jasser-bougatef/venom-combat-robot/docs/choix_materiel.pdf

# Choix matériels

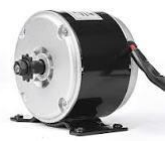
[picture p23: figure]

# Moteur : MY1016

## - Caractéristiques

Consommation de courant

À vide ➔ courant de 1-2A

En charge normale ➔ autour de 15A

En démarrage brutal ou blocage ➔ 30-40A en pointe

# Driver moteur :

Driver | Prix | Ses avantages
Cytron MDDS60 | 670d « ali express » | 60A
Flipsky FSESC 4.20 | 557 d « ubuy » | 50A + refrodissement
Sabertooth 2x32 | 120,00 € « go tronic » | 32A
Bts7960B | 21d « 2b » | 15 à 20A
- Essaie de rendre mon bts7960 B comme les autres driver
- Monte ton BTS7960 sur une plaque aluminium (radiateur bricolé).
- Prends une plaque métallique fine.
- Visse ou colle ton BTS7960 dessus pour aider à refroidir.
- Ajoute un ventilateur 5V ou 12V directement pointé sur le module.
- Un petit ventilateur PC (4x4 cm) suffit.
- L’alimentation du ventilateur peut venir de ta batterie via un petit régulateur.
- Utilise de GROS câbles entre la batterie, le BTS7960 et le moteur.
- Type 10 AWG ou 12 AWG si possible.
- Soude un condensateur directement sur l’alim du BTS7960.
- Exemple : 1000µF 35V entre VCC et GND pour lisser les pics de tension.
- Mets un fusible rapide sur le câble positif venant de ta batterie.

Code coleur :

Rouge : obligatoire

Vert : recommandé

Jaune : optionnel

- Valeur : 25A ou 30A (ça protège ton BTS7960).
- Évite de tirer 100% de la puissance moteur tout le temps.
- Si possible, limite l'accélération via ton code Arduino (PWM progressif).

# Alimentation :

Une batterie Li-Po 6S (qui signifie 6 cellules en série) est idéale, car elle fournit une tension de 22.2V nominale (3.7V x 6) et jusqu'à 25.2V à pleine charge, ce qui est parfaitement adapté pour un moteur 24V.

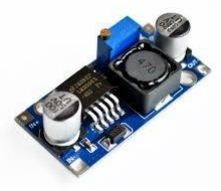
[picture p24: figure]

Carte commande : esp32 + un convertisseur buck

(LM2596 5.4 D ) convertir 24 v en 5 v pour alimente le carte esp 32 )

# Manette
