jasser-bougatef/venom-combat-robot/analysis/shaft_bending/1f.png

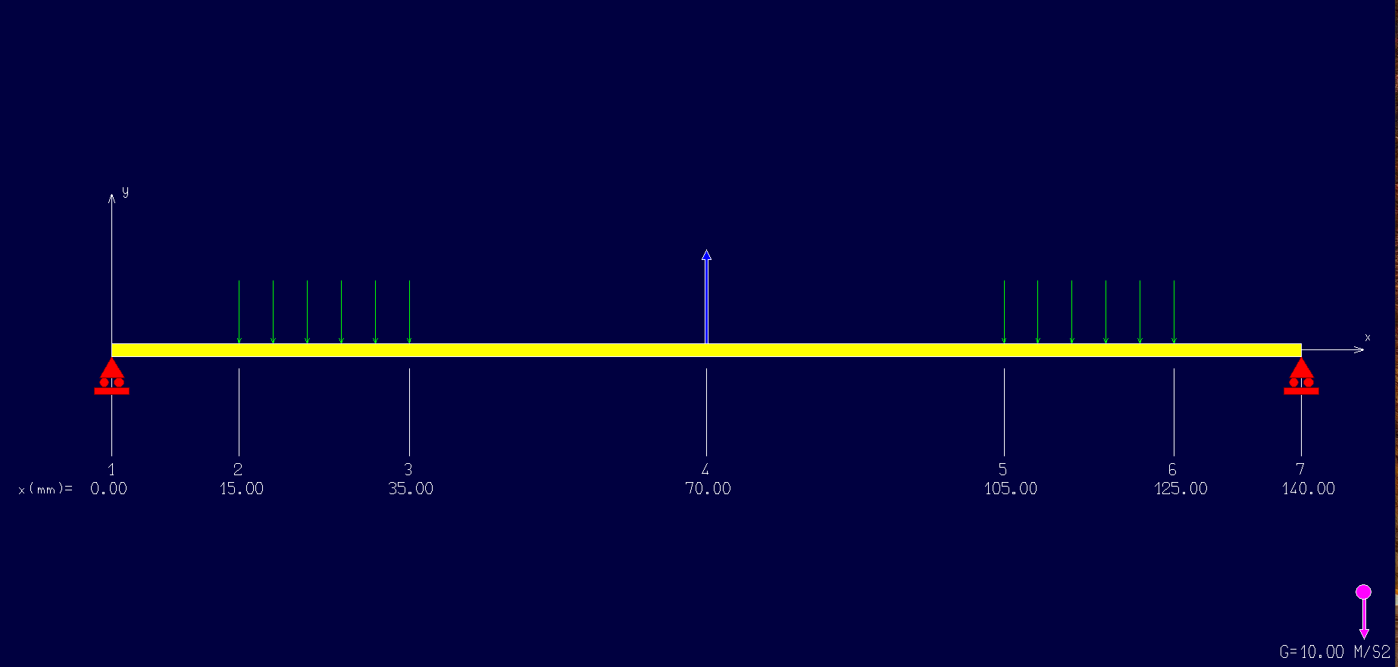
analysis/shaft_bending/1f.png
