jasser-bougatef/venom-combat-robot/analysis/shaft_bending/capture.png

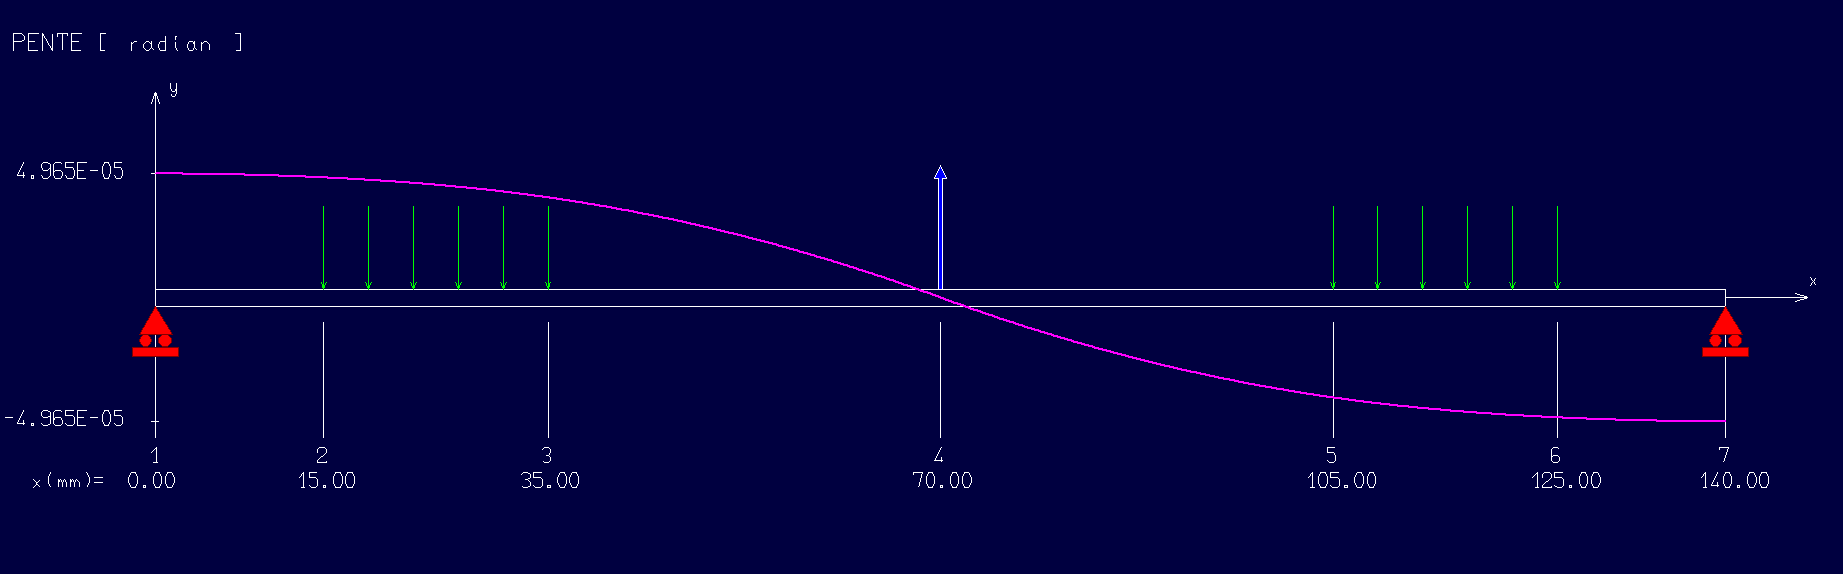
analysis/shaft_bending/capture.png
