jasser-bougatef/venom-combat-robot/analysis/shaft_bending/f2.png

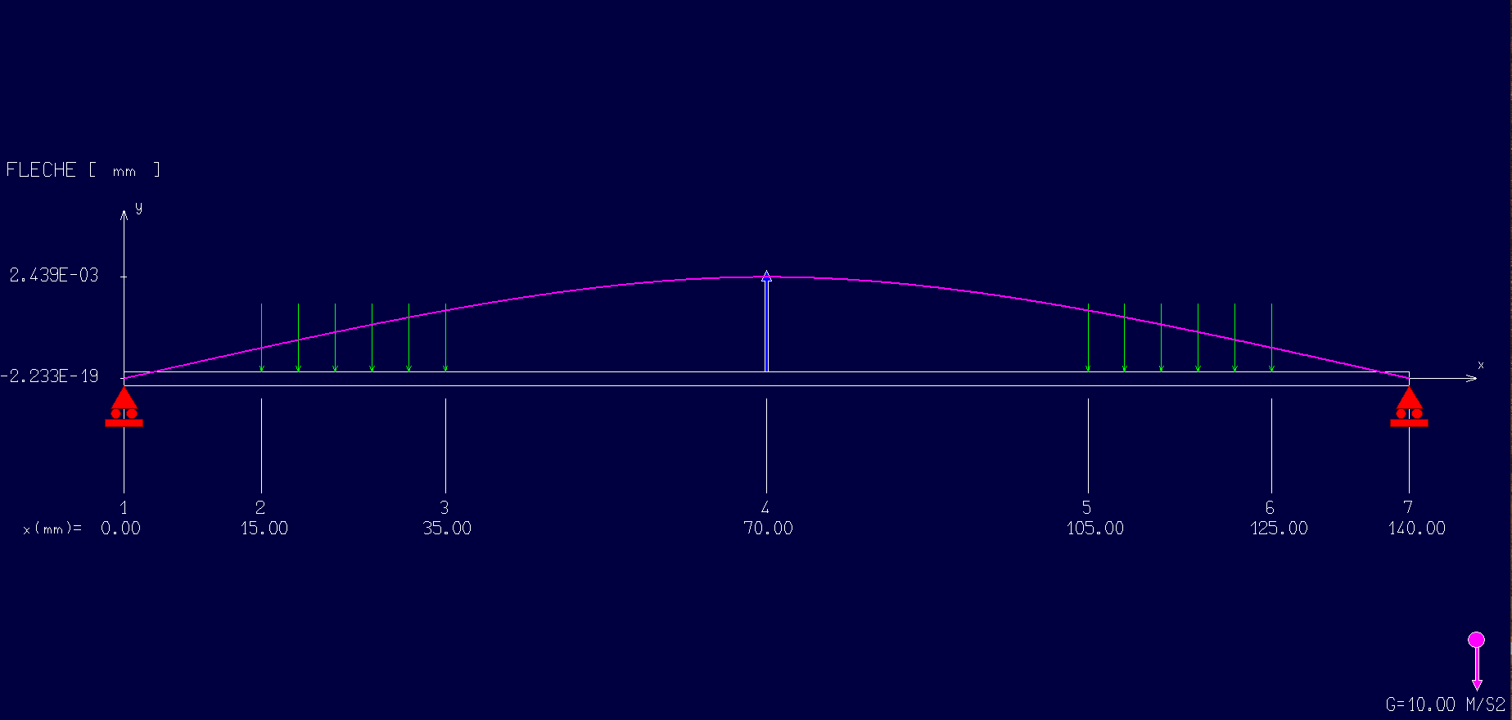
analysis/shaft_bending/f2.png
