jasser-bougatef/venom-combat-robot/analysis/shaft_bending/f3.png

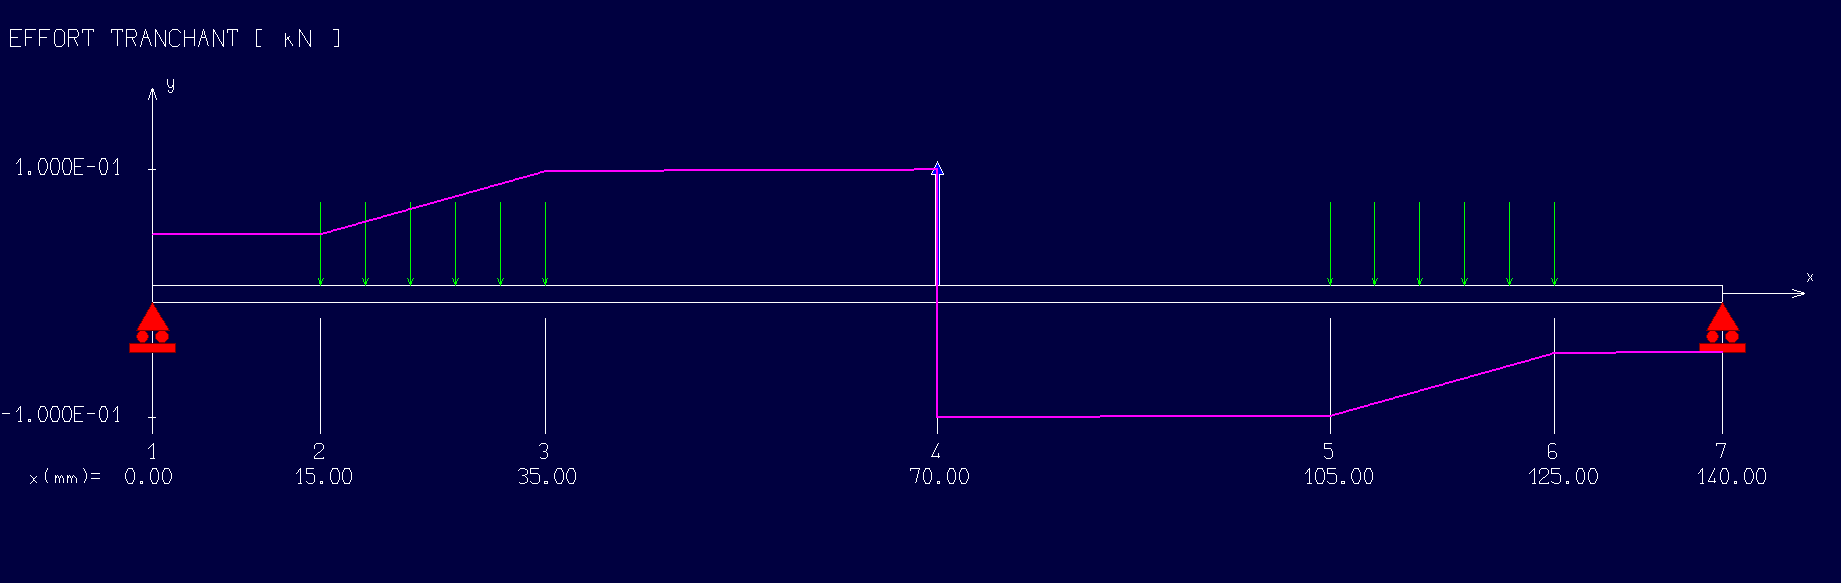
analysis/shaft_bending/f3.png
