jasser-bougatef/venom-combat-robot/analysis/shaft_bending/f4.png

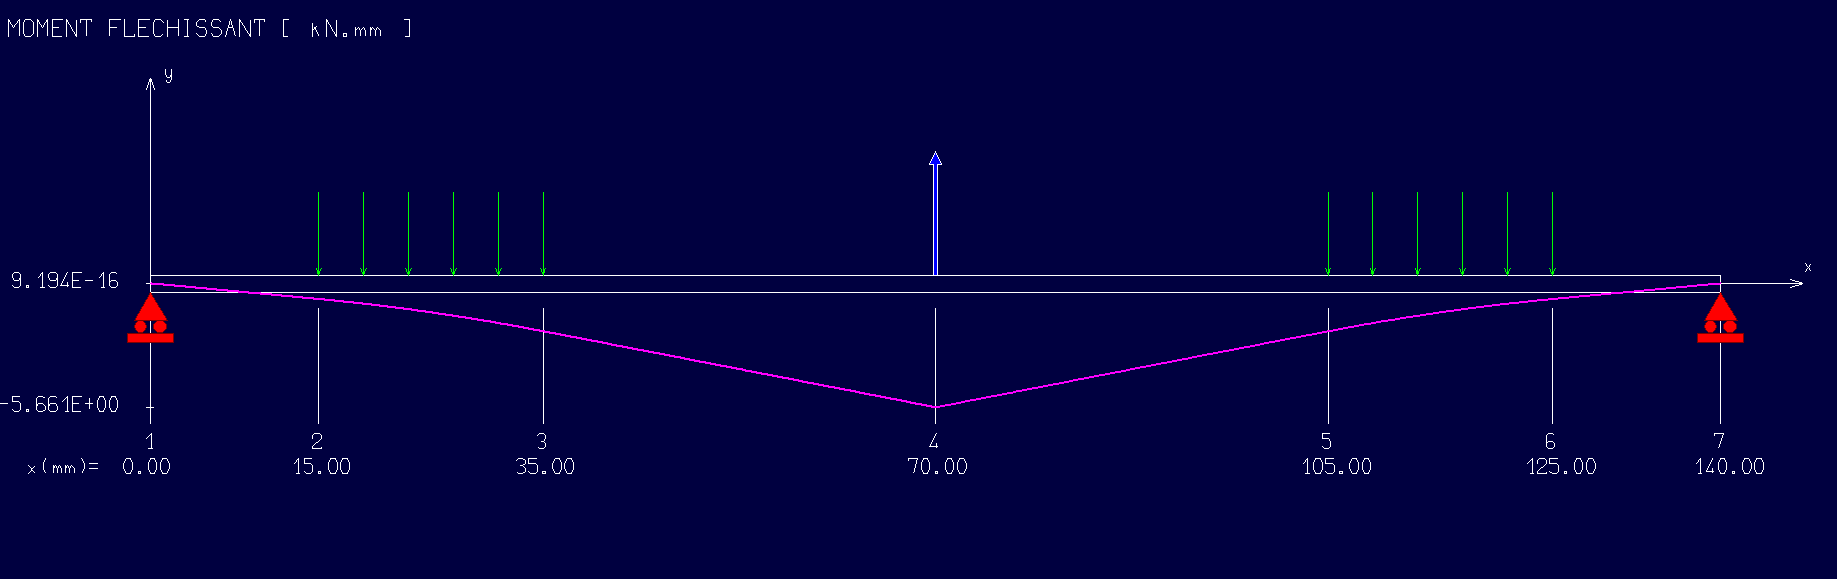
analysis/shaft_bending/f4.png
