jasser-bougatef/venom-combat-robot/analysis/shaft_bending/f5.png

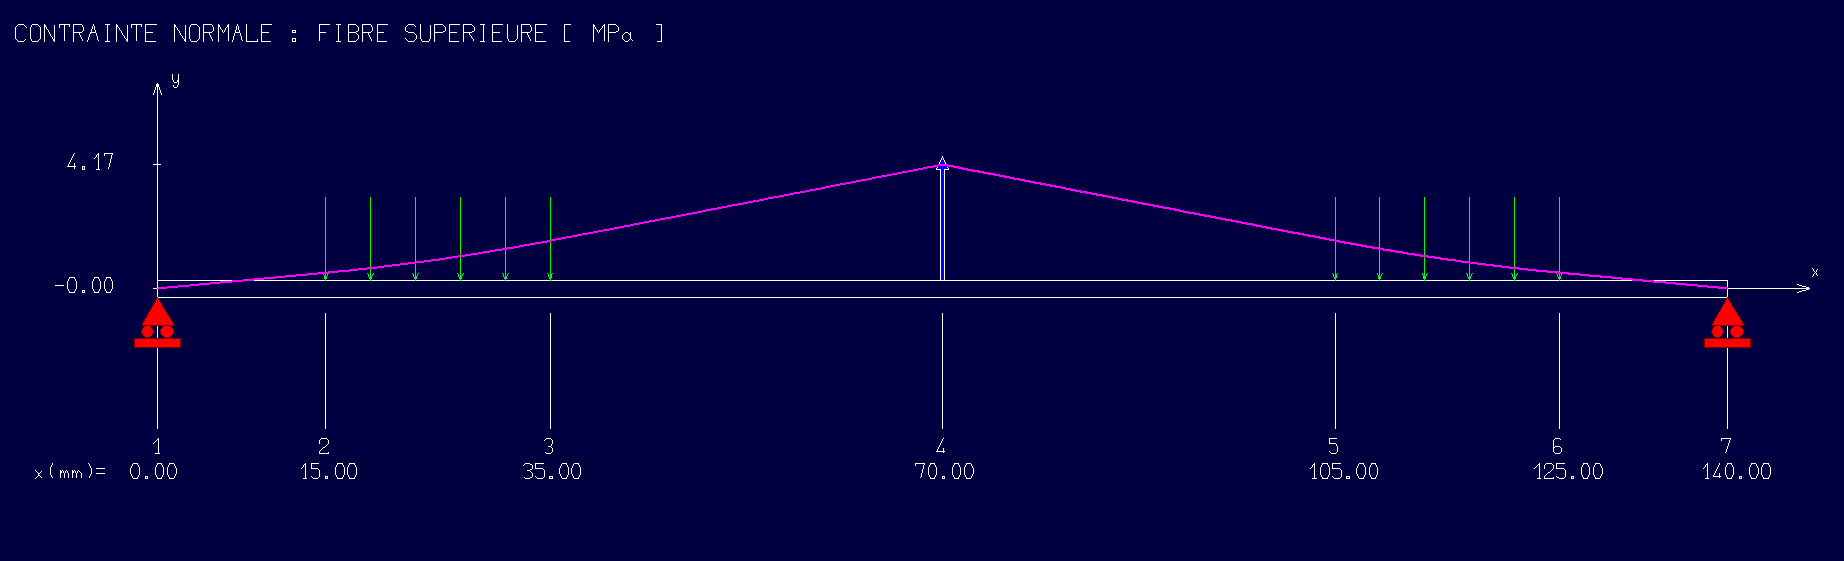
analysis/shaft_bending/f5.png
