jasser-bougatef/venom-combat-robot/analysis/shaft_bending/f6.png

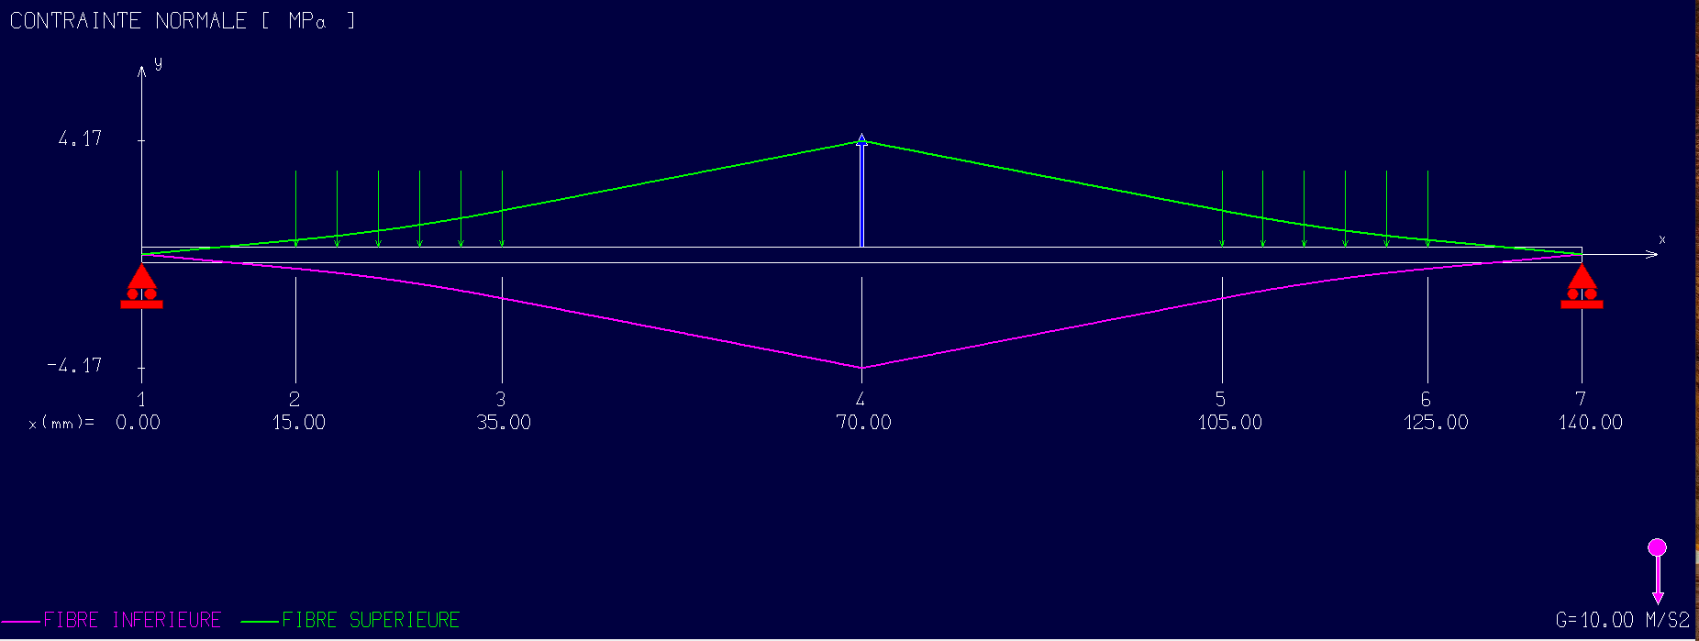
analysis/shaft_bending/f6.png
