jasser-bougatef/venom-combat-robot/analysis/shaft_bending/f7.png

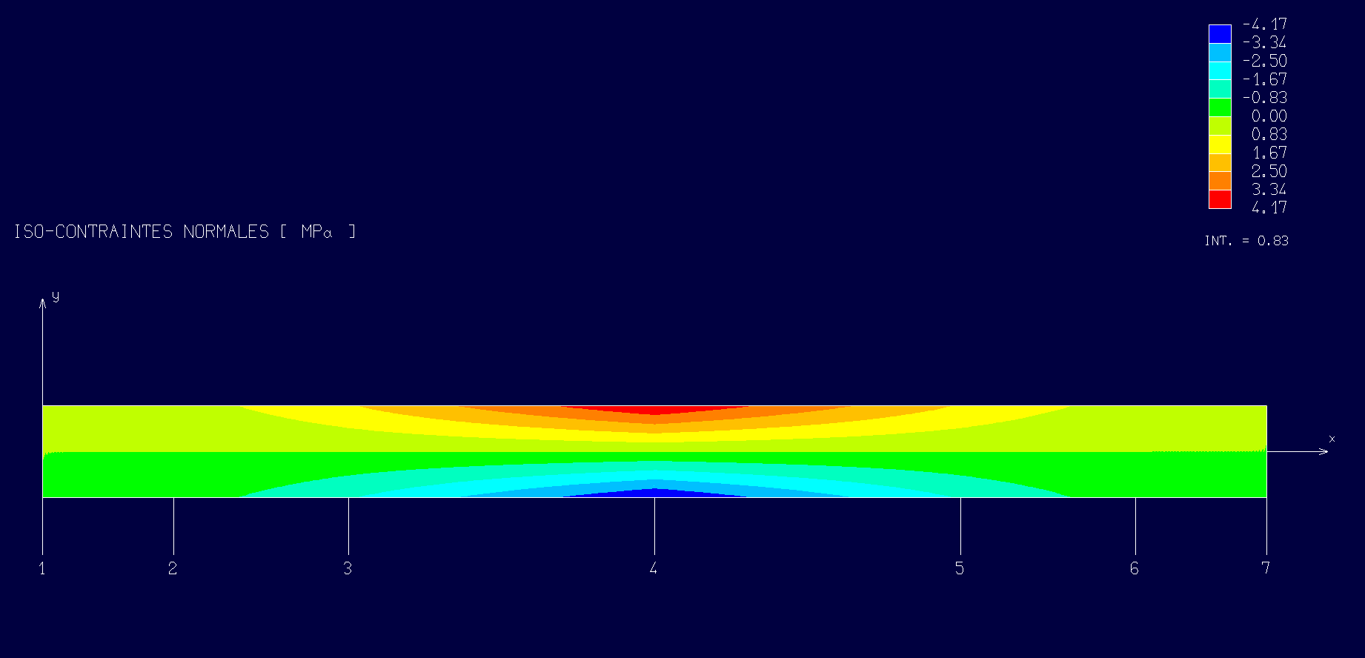
analysis/shaft_bending/f7.png
