jasser-bougatef/venom-combat-robot/cad/images/vue_1.png

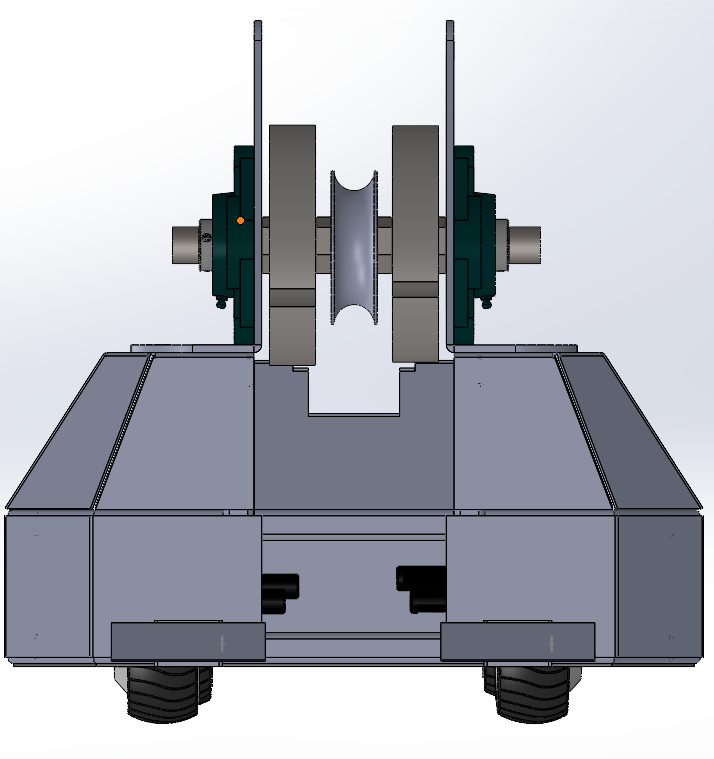
cad/images/vue_1.png
