jasser-bougatef/venom-combat-robot/cad/images/vue_2.png

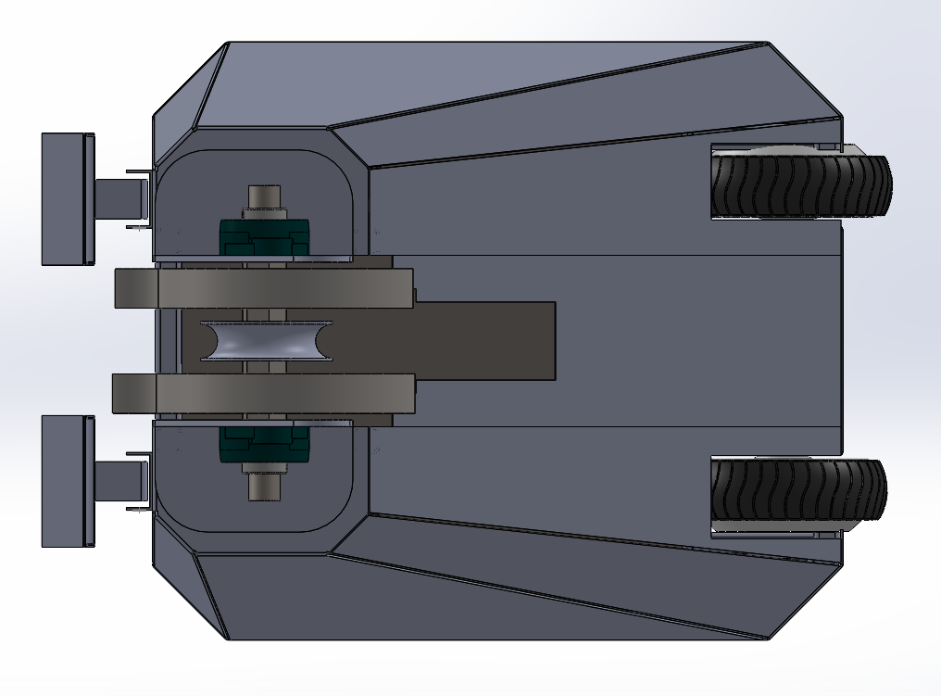
cad/images/vue_2.png
