jasser-bougatef/venom-combat-robot/cad/images/vue_3.png

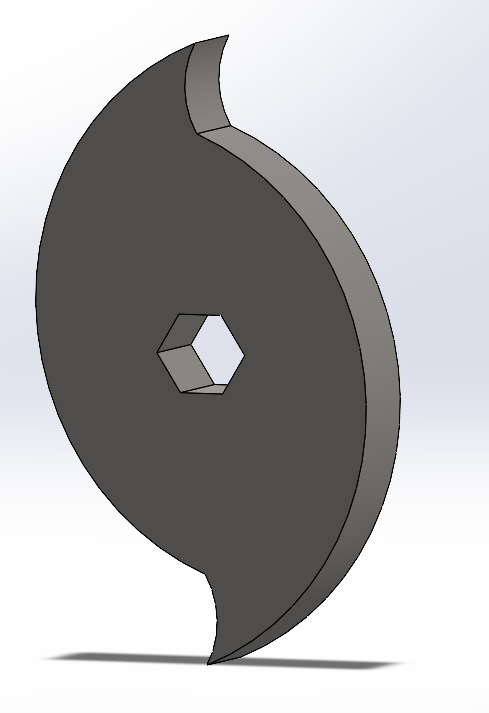
cad/images/vue_3.png
