jasser-bougatef/venom-combat-robot/cad/images/vue_4.png

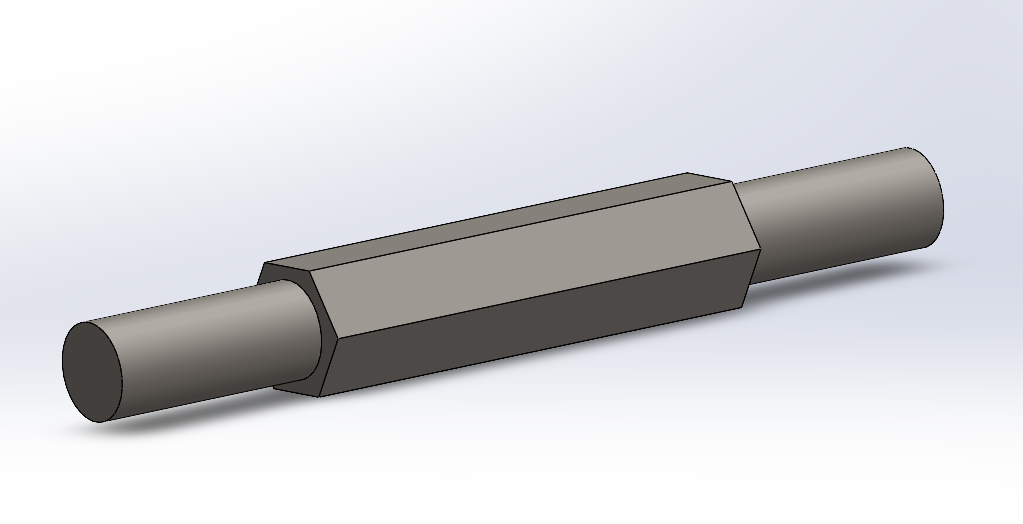
cad/images/vue_4.png
