jasser-bougatef/venom-combat-robot/electrical/images/commande_arme.png

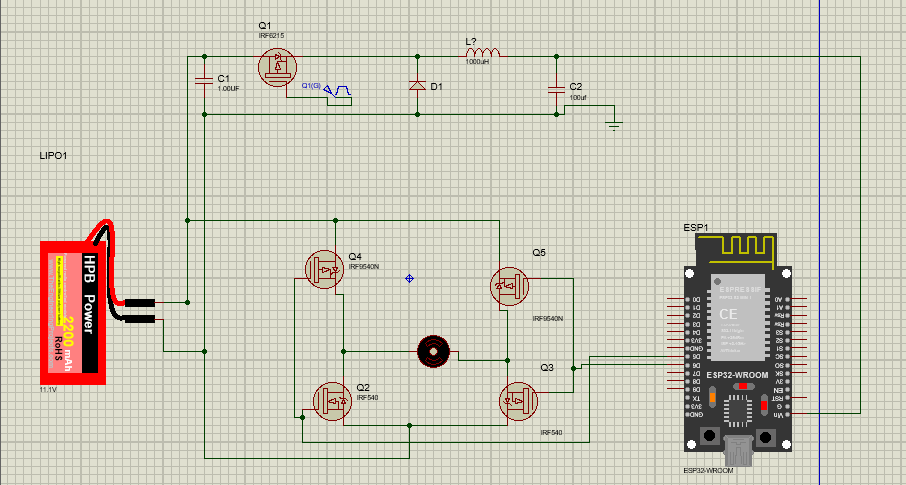
electrical/images/commande_arme.png
