jasser-bougatef/venom-combat-robot/electrical/images/commande_moteurs.png

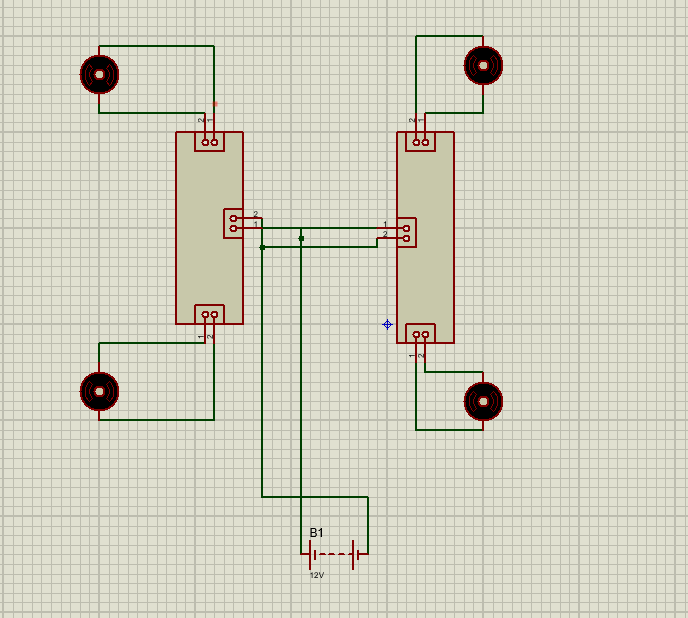
electrical/images/commande_moteurs.png
