jasser-bougatef/venom-combat-robot/firmware/hoverboard_stm32/carte_hoverboard.jpg

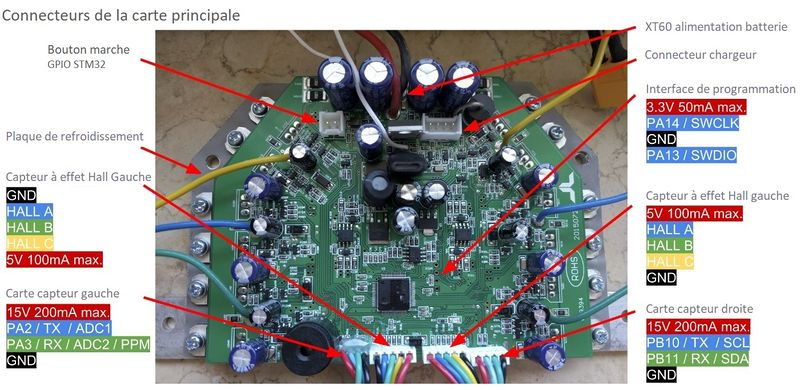
firmware/hoverboard_stm32/carte_hoverboard.jpg
