jasser-bougatef/venom-combat-robot/firmware/hoverboard_stm32/st_link_flash.jpg

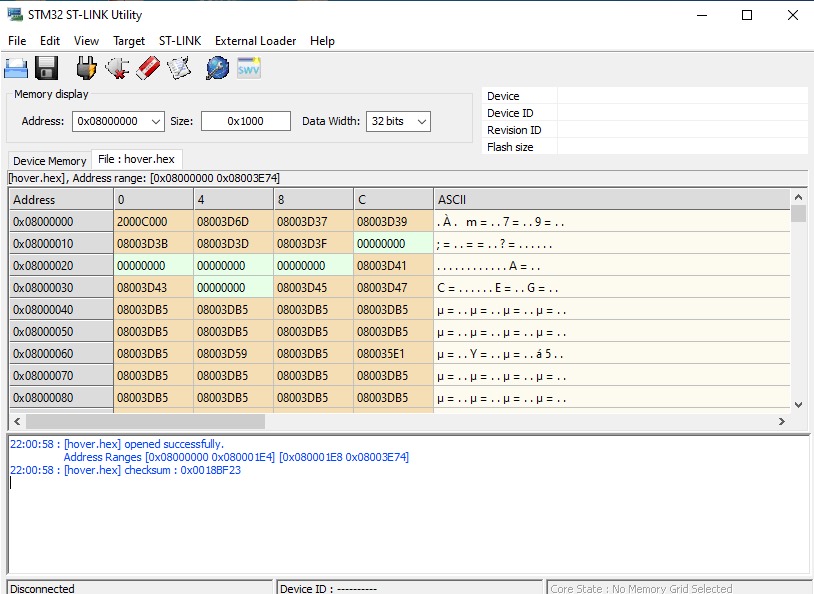
firmware/hoverboard_stm32/st_link_flash.jpg
