jasser-bougatef/venom-combat-robot/media/venom-abaqus.jpg

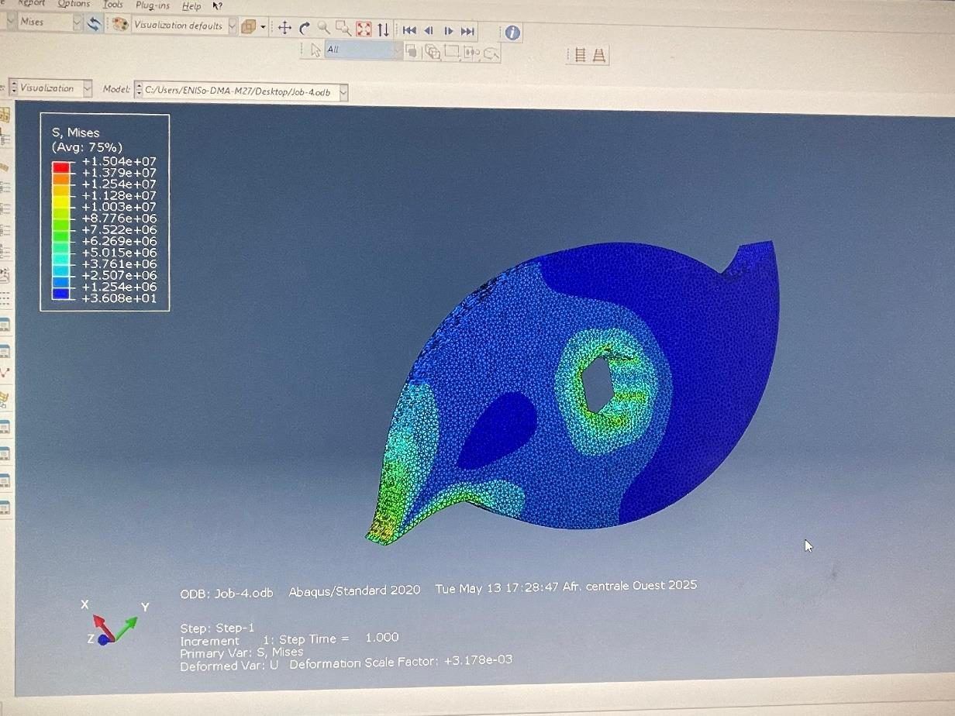
media/venom-abaqus.jpg
