jasser-bougatef/venom-combat-robot/media/venom-team.jpg

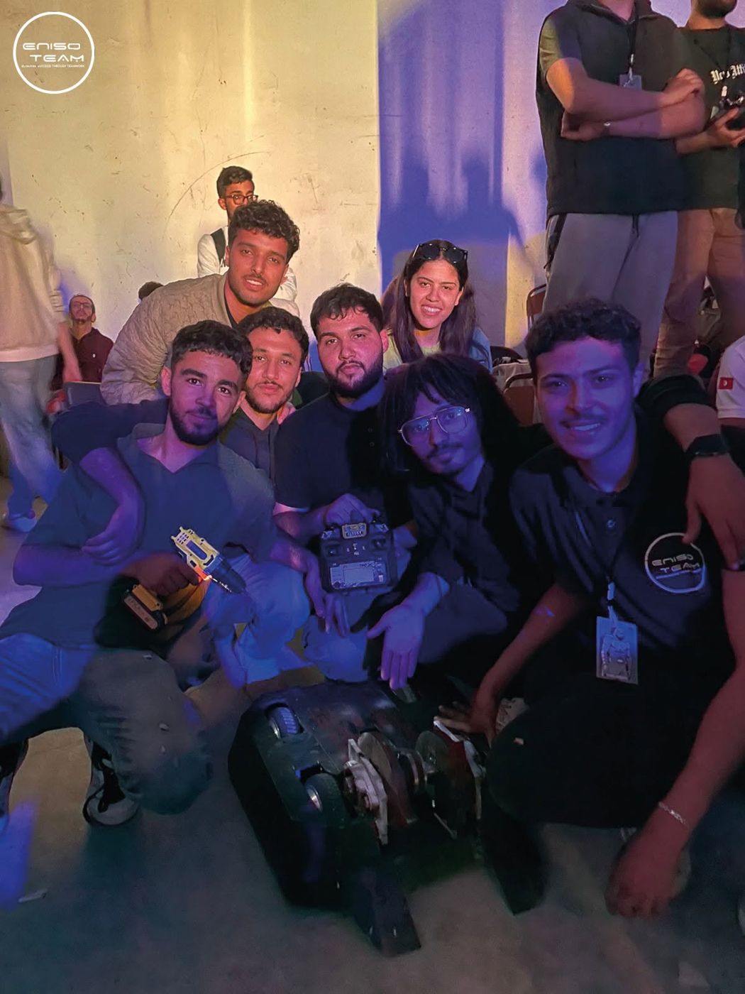
media/venom-team.jpg
