jasser-bougatef/venom-combat-robot/cad/solidworks/fighter bot.SLDASM

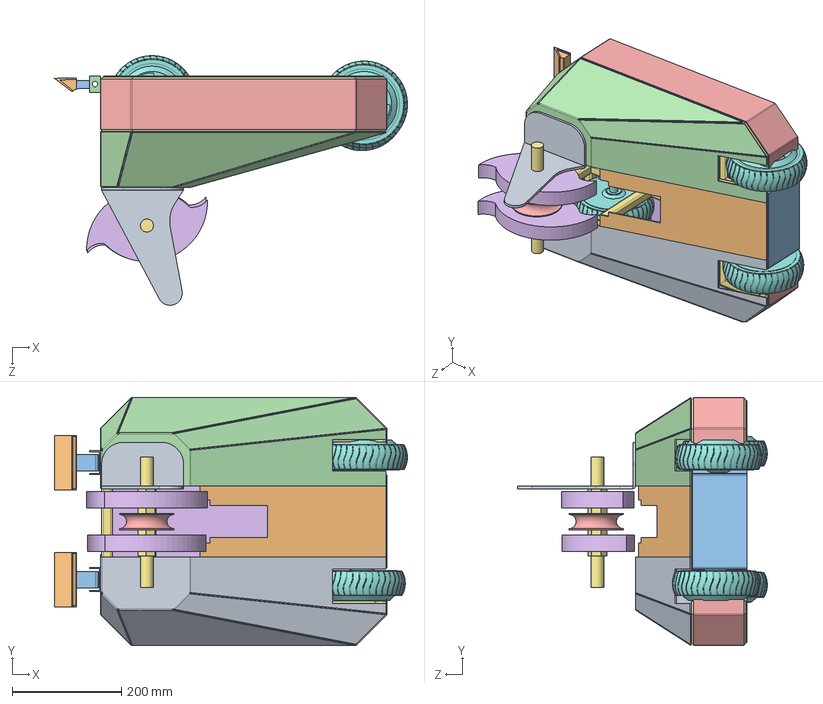
[picture p43: CAD file, 2026-11-05]
cad/solidworks/fighter bot.SLDASM
645.7 x 454.0 x 456.8 mm
fighter
tole
tole lateral x 2
tole haut
tole arriere
tole haut 2
tole fzefzef
Motor, BLDC, Hoverboard Wheel, 6.5in.stp x 4
arbre death
arm venom x 2
polie de l'arbre de l'arme
base ta3 pente x 2
support pente x 2
pente men goddem x 2
Symétrietole haut
