jasser-bougatef/venom-combat-robot/cad/solidworks/pente.SLDASM

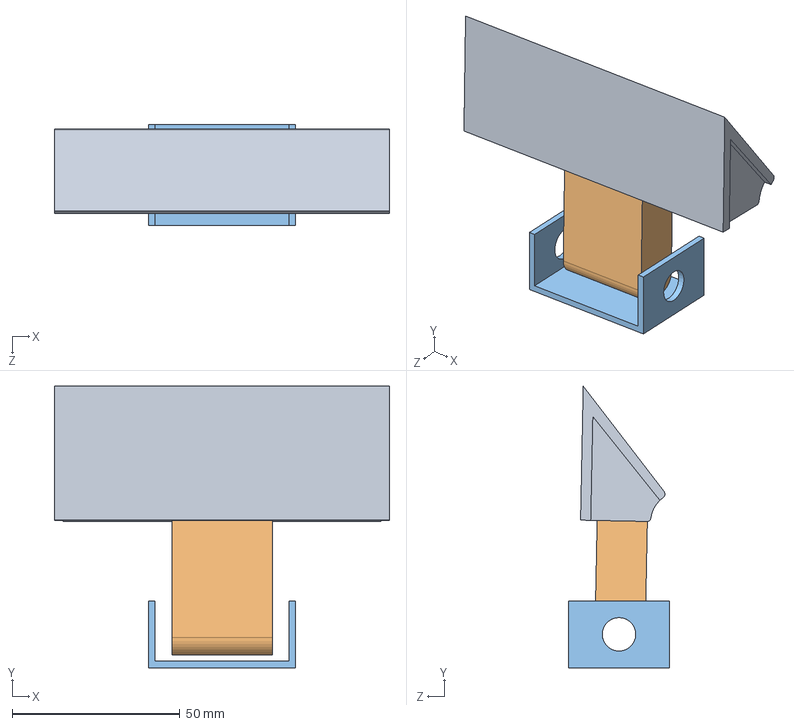
[picture p44: CAD file, 2026-11-05]
cad/solidworks/pente.SLDASM
100.0 x 84.1 x 30.0 mm
base ta3 pente
support pente
pente men goddem
