jasser-bougatef/venom-combat-robot/cad/solidworks/tole lateral.SLDPRT

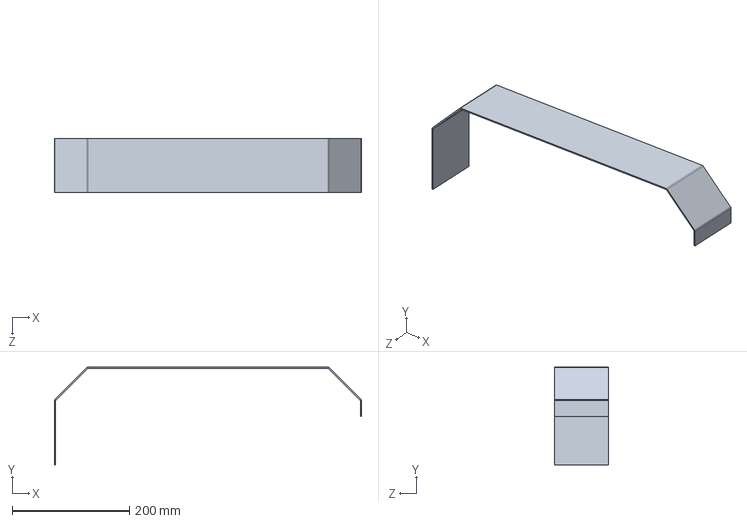
[picture p45: CAD file, 2026-11-05]
cad/solidworks/tole lateral.SLDPRT
524.0 x 167.0 x 92.0 mm
