jasser-bougatef/venom-combat-robot/cad/solidworks/polie de l'arbre de l'arme.SLDPRT

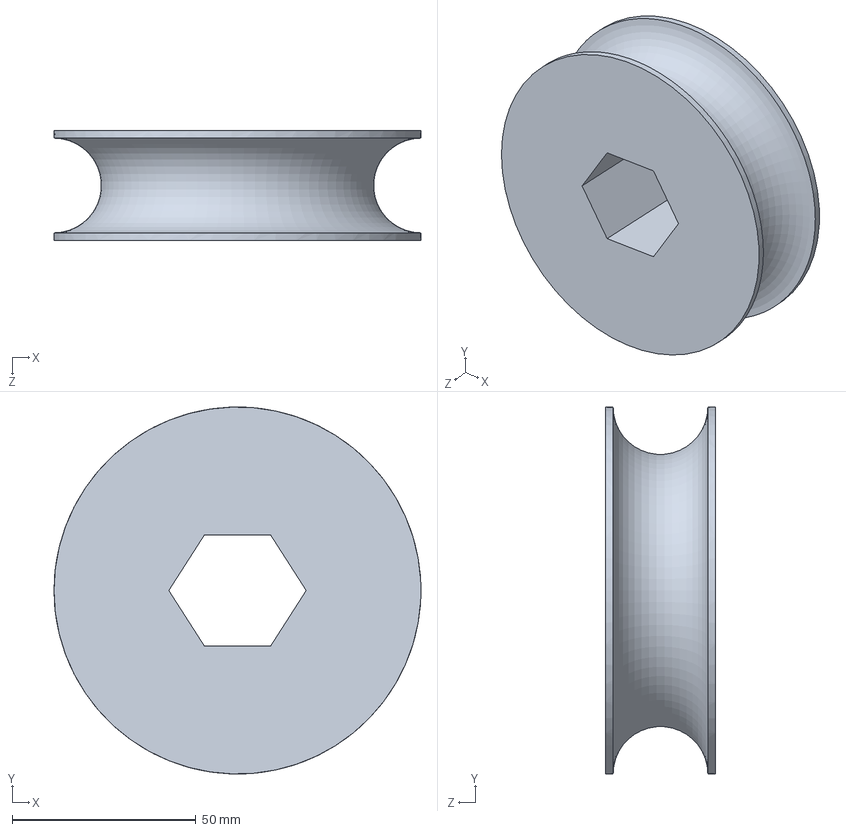
[picture p46: CAD file, 2026-11-05]
cad/solidworks/polie de l'arbre de l'arme.SLDPRT
100.0 x 100.0 x 30.0 mm
