jasser-bougatef/venom-combat-robot/cad/solidworks/tole fzefzef.SLDPRT

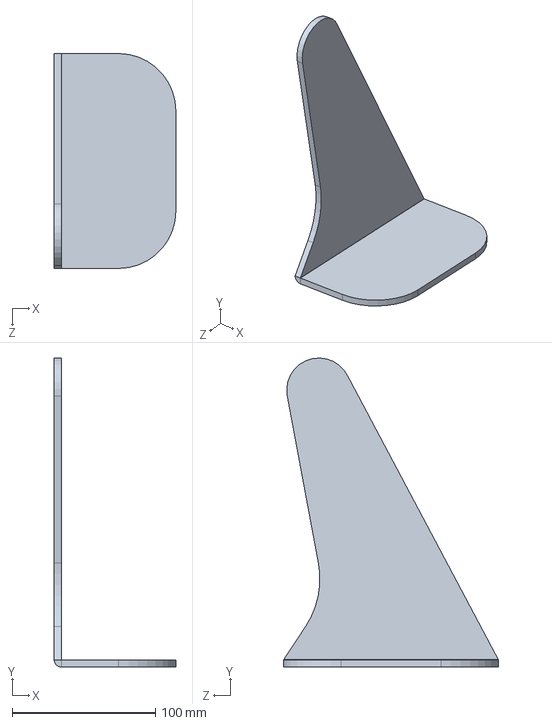
[picture p47: CAD file, 2026-11-05]
cad/solidworks/tole fzefzef.SLDPRT
85.0 x 215.7 x 150.0 mm
