jasser-bougatef/venom-combat-robot/cad/solidworks/pente men goddem.SLDPRT

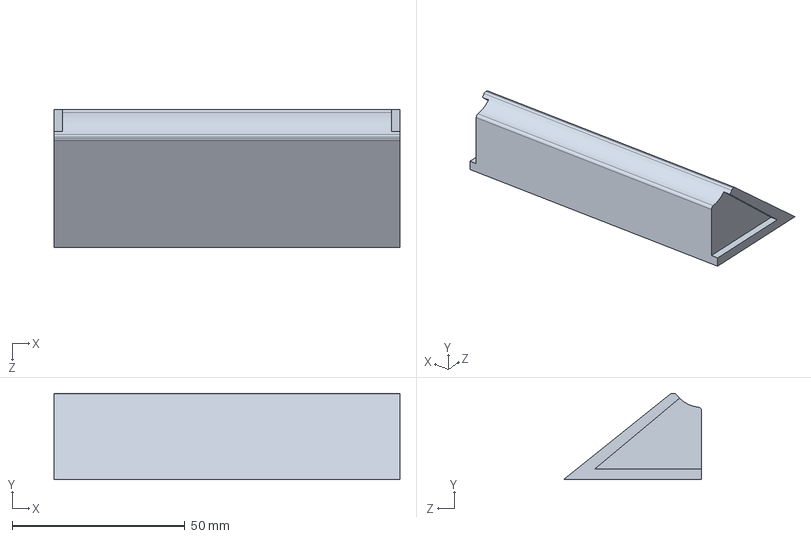
[picture p48: CAD file, 2026-11-05]
cad/solidworks/pente men goddem.SLDPRT
100.0 x 25.0 x 40.0 mm
