jasser-bougatef/venom-combat-robot/cad/solidworks/tole haut.SLDPRT

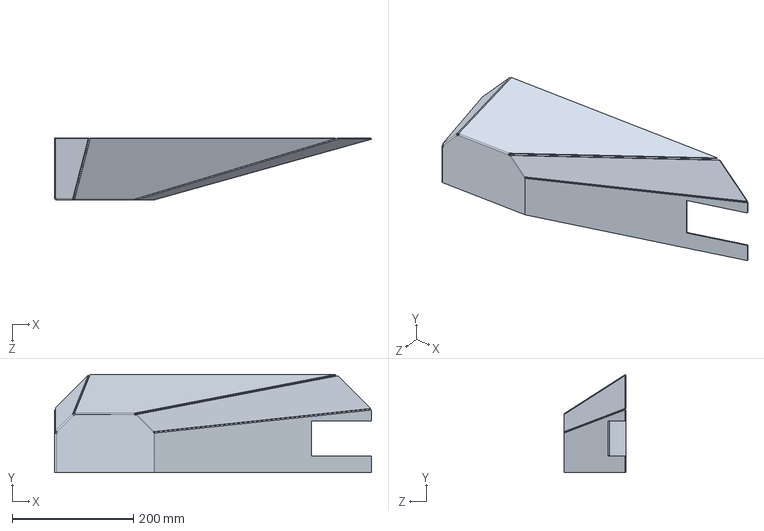
[picture p49: CAD file, 2026-11-05]
cad/solidworks/tole haut.SLDPRT
522.5 x 161.7 x 102.0 mm
