jasser-bougatef/venom-combat-robot/cad/solidworks/tole.SLDPRT

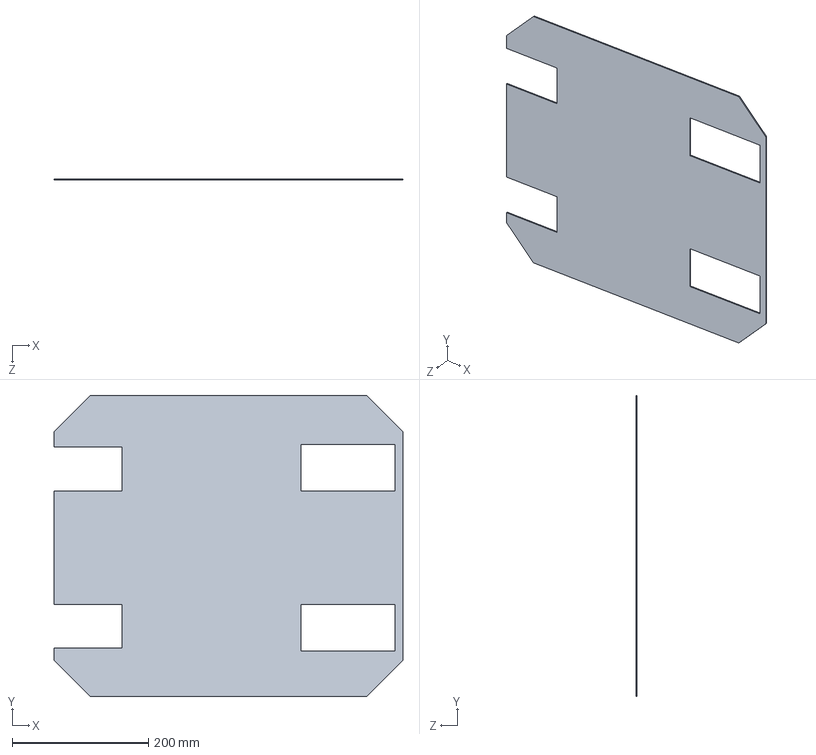
[picture p50: CAD file, 2026-11-05]
cad/solidworks/tole.SLDPRT
512.0 x 442.0 x 2.00 mm
