jasser-bougatef/venom-combat-robot/cad/solidworks/base ta3 pente.SLDPRT

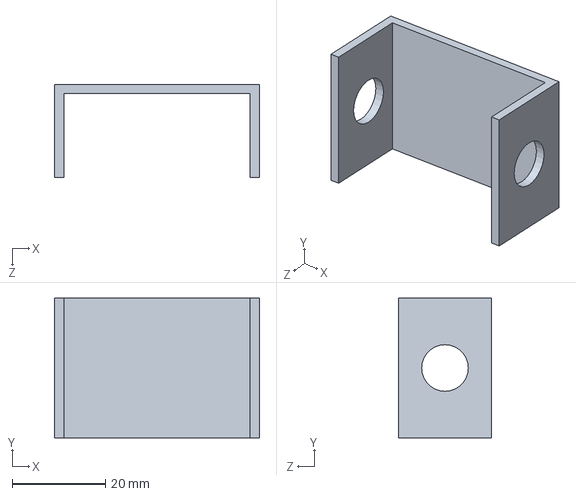
[picture p51: CAD file, 2026-11-05]
cad/solidworks/base ta3 pente.SLDPRT
44.0 x 30.0 x 20.0 mm
