jasser-bougatef/venom-combat-robot/cad/solidworks/arbre death.SLDPRT

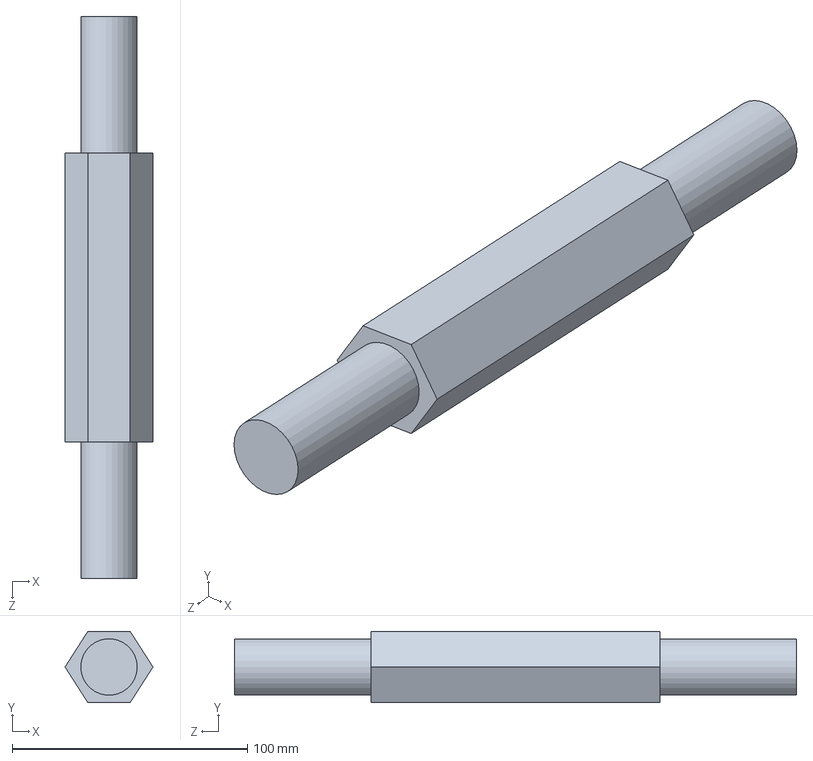
[picture p52: CAD file, 2026-11-05]
cad/solidworks/arbre death.SLDPRT
37.4 x 30.3 x 239.0 mm
