jasser-bougatef/venom-combat-robot/cad/solidworks/support pente.SLDPRT

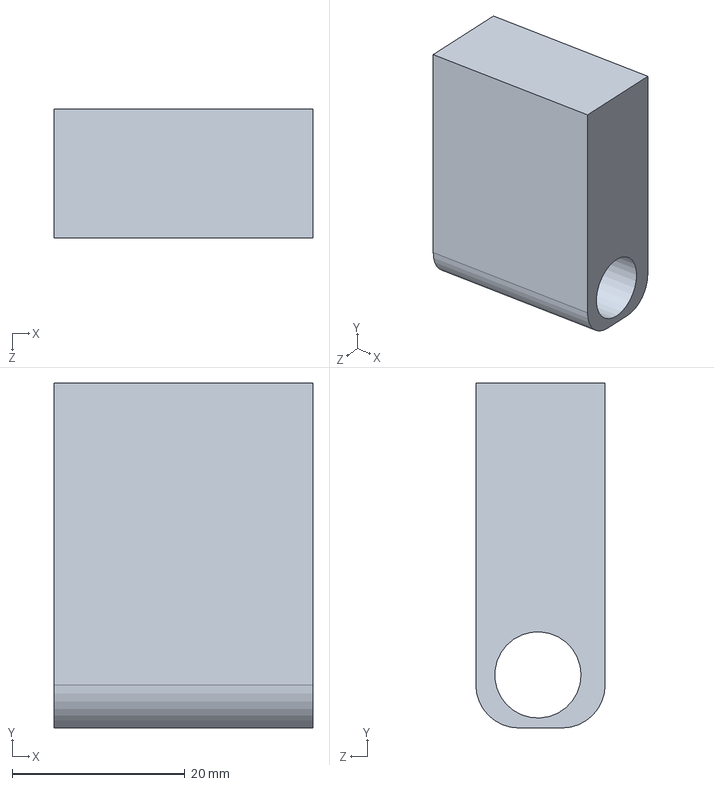
[picture p53: CAD file, 2026-11-05]
cad/solidworks/support pente.SLDPRT
30.0 x 40.0 x 15.0 mm
