jasser-bougatef/venom-combat-robot/cad/solidworks/arm venom.SLDPRT

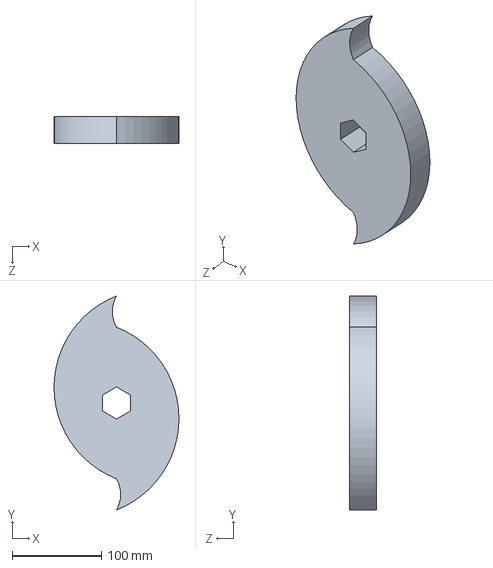
[picture p54: CAD file, 2026-11-05]
cad/solidworks/arm venom.SLDPRT
140.2 x 240.0 x 30.0 mm
