jasser-bougatef/venom-combat-robot/cad/solidworks/tole arriere.SLDPRT

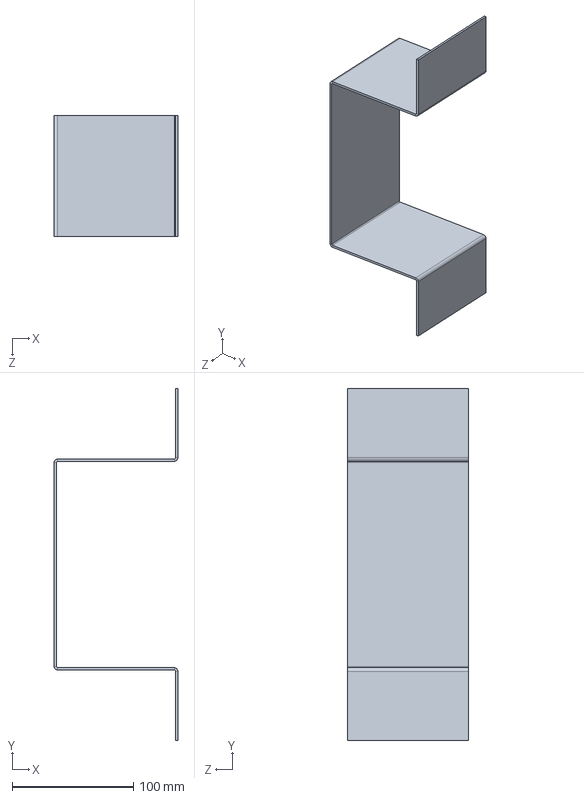
[picture p55: CAD file, 2026-11-05]
cad/solidworks/tole arriere.SLDPRT
102.0 x 290.0 x 100.0 mm
