jasser-bougatef/venom-combat-robot/cad/solidworks/fighter.SLDPRT

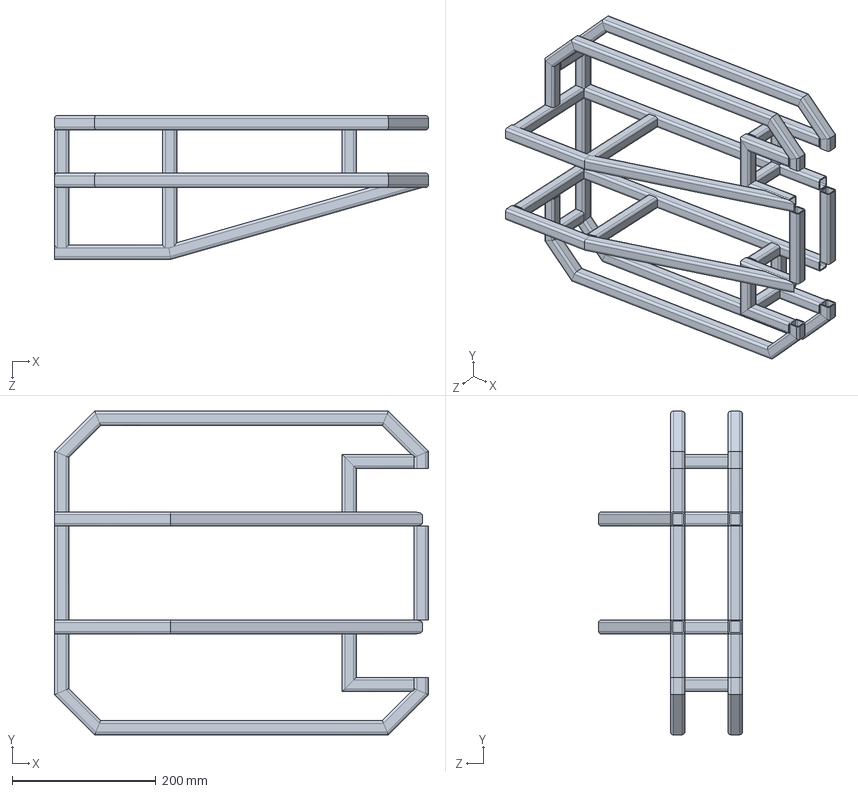
[picture p56: CAD file, 2026-11-05]
cad/solidworks/fighter.SLDPRT
520.0 x 450.0 x 200.0 mm
