jasser-bougatef/venom-combat-robot/cad/solidworks/tole haut 2.SLDPRT

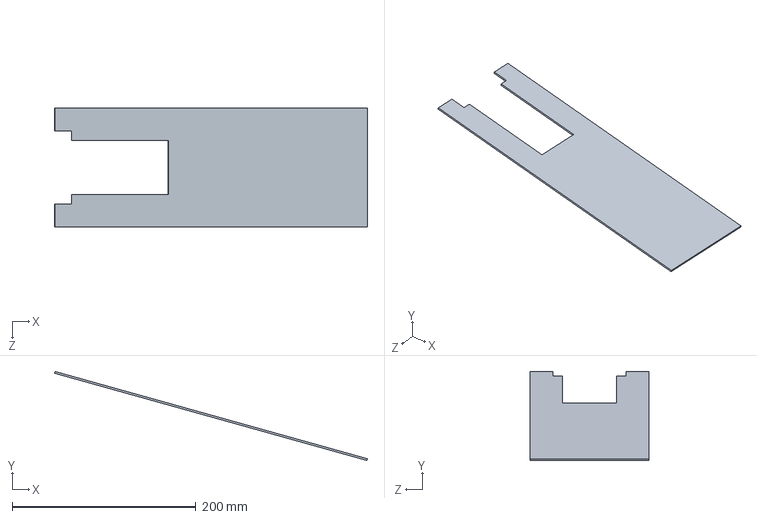
[picture p57: CAD file, 2026-11-05]
cad/solidworks/tole haut 2.SLDPRT
340.8 x 97.0 x 130.0 mm
