jasser-bougatef/venom-combat-robot/cad/solidworks/Motor, BLDC, Hoverboard Wheel, 6.5in.stp.SLDPRT

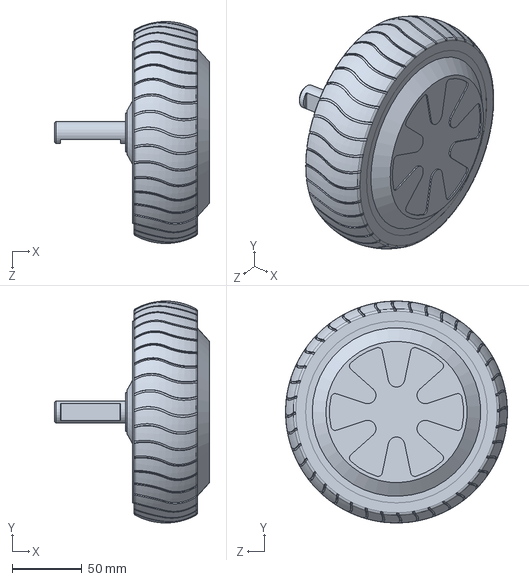
[picture p58: CAD file, 2026-11-05]
cad/solidworks/Motor, BLDC, Hoverboard Wheel, 6.5in.stp.SLDPRT
111.0 x 158.7 x 158.7 mm
