jasser-bougatef/venom-combat-robot/(list of files, cad)

Other CAD files:
cad/solidworks/Symétrietole haut.SLDPRT
cad/solidworks/arm1.SLDPRT
cad/solidworks/Symétrietole fzefzef.SLDPRT
cad/solidworks/24215-25205.SLDASM
cad/solidworks/24215-25205_01.SLDPRT
cad/solidworks/24215-25205_02.SLDPRT
