jasser-bougatef/venom-combat-robot/analysis/abaqus_impact/resultat_03.jpg

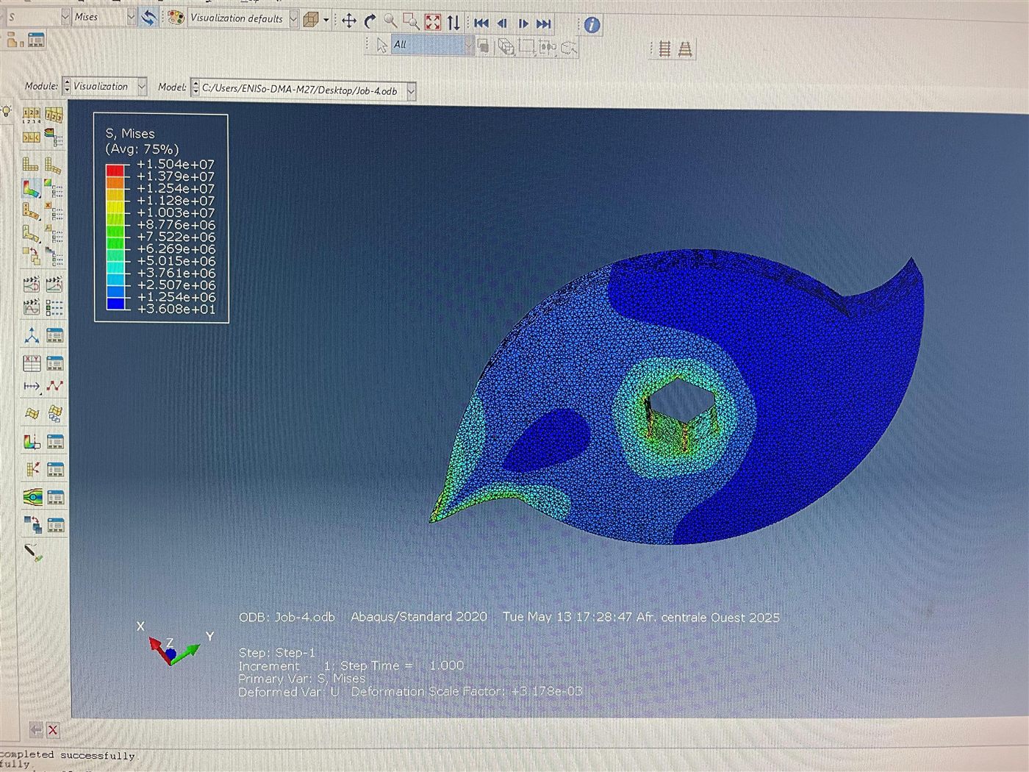
analysis/abaqus_impact/resultat_03.jpg
