jasser-bougatef/venom-combat-robot/analysis/abaqus_impact/resultat_04.jpg

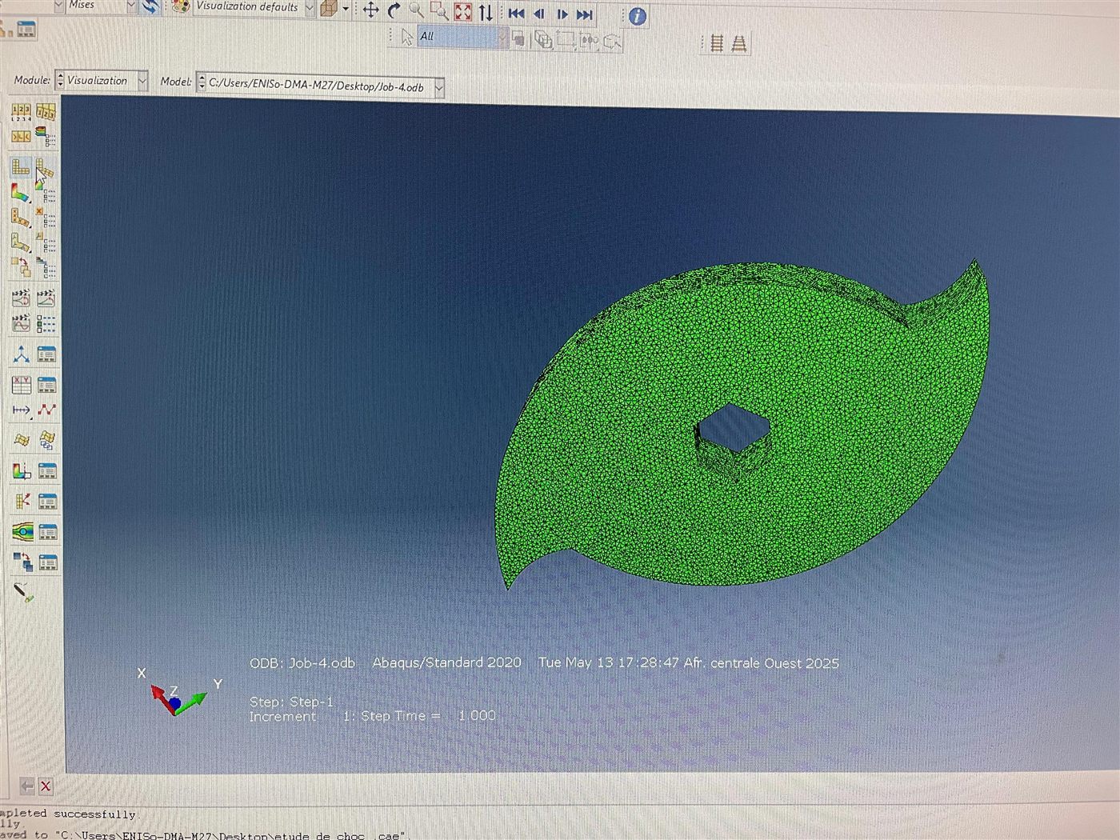
analysis/abaqus_impact/resultat_04.jpg
