jasser-bougatef/venom-combat-robot/analysis/abaqus_impact/resultat_05.jpg

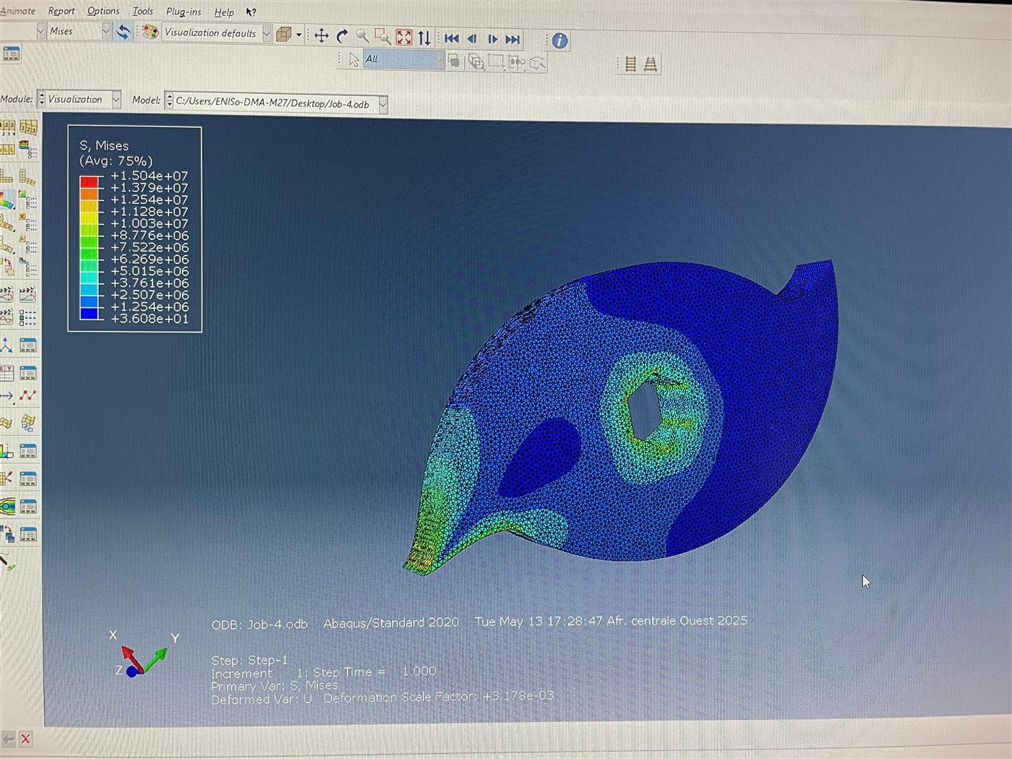
analysis/abaqus_impact/resultat_05.jpg
