jasser-bougatef/venom-combat-robot/analysis/abaqus_impact/resultat_09.jpg

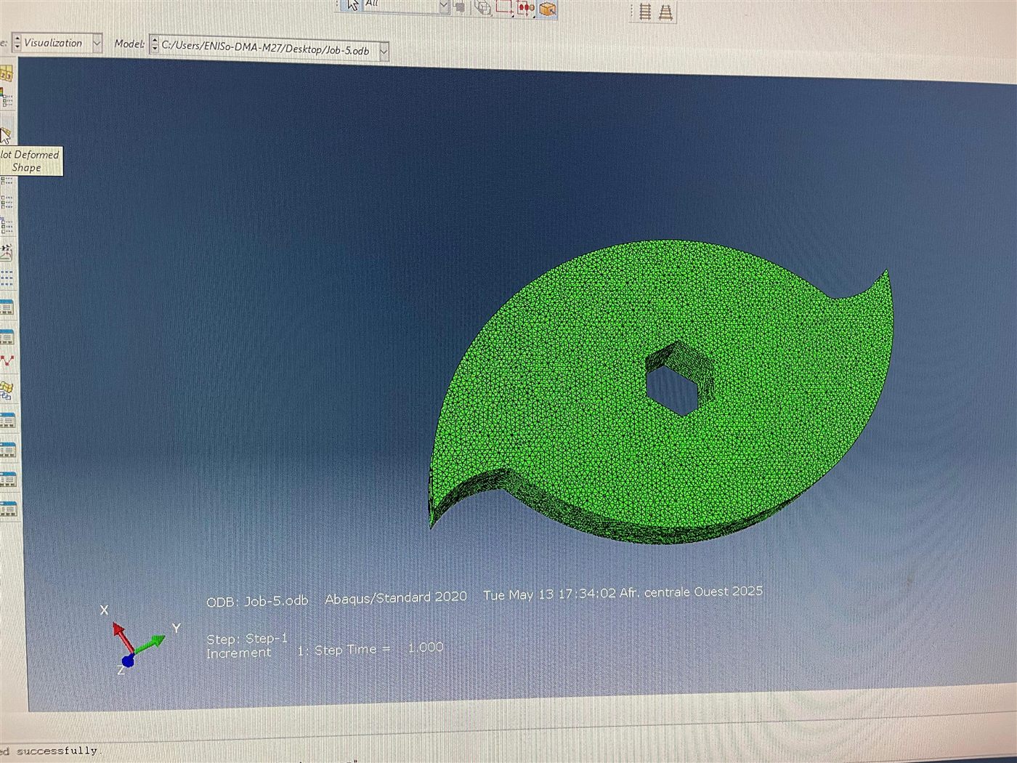
analysis/abaqus_impact/resultat_09.jpg
