jasser-bougatef/venom-combat-robot/analysis/abaqus_impact/resultat_10.jpg

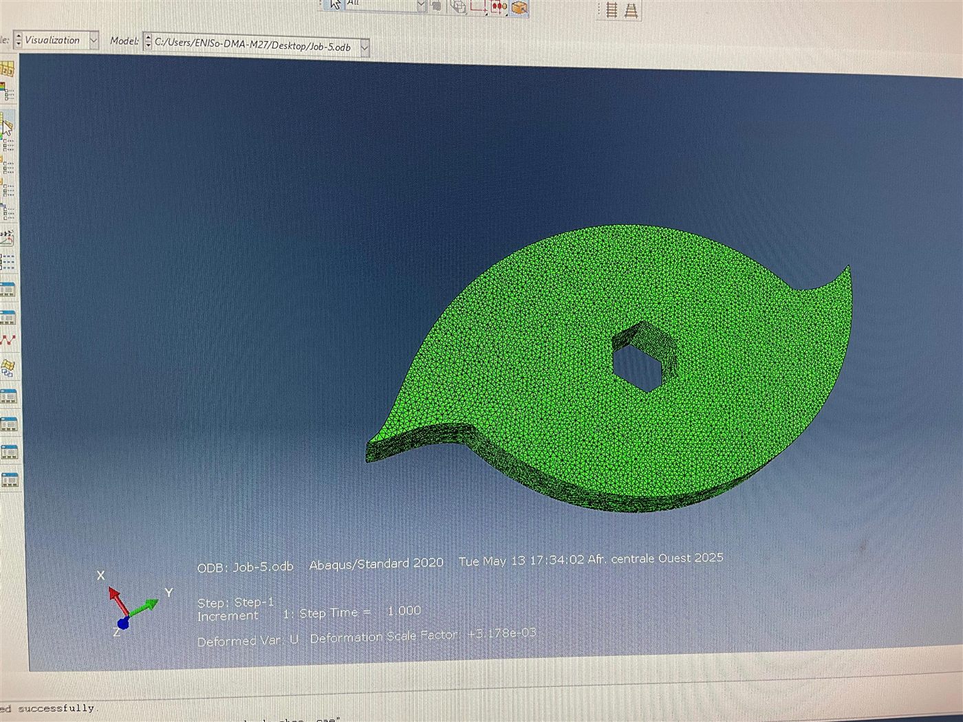
analysis/abaqus_impact/resultat_10.jpg
