jasser-bougatef/venom-combat-robot/analysis/abaqus_impact/resultat_11.jpg

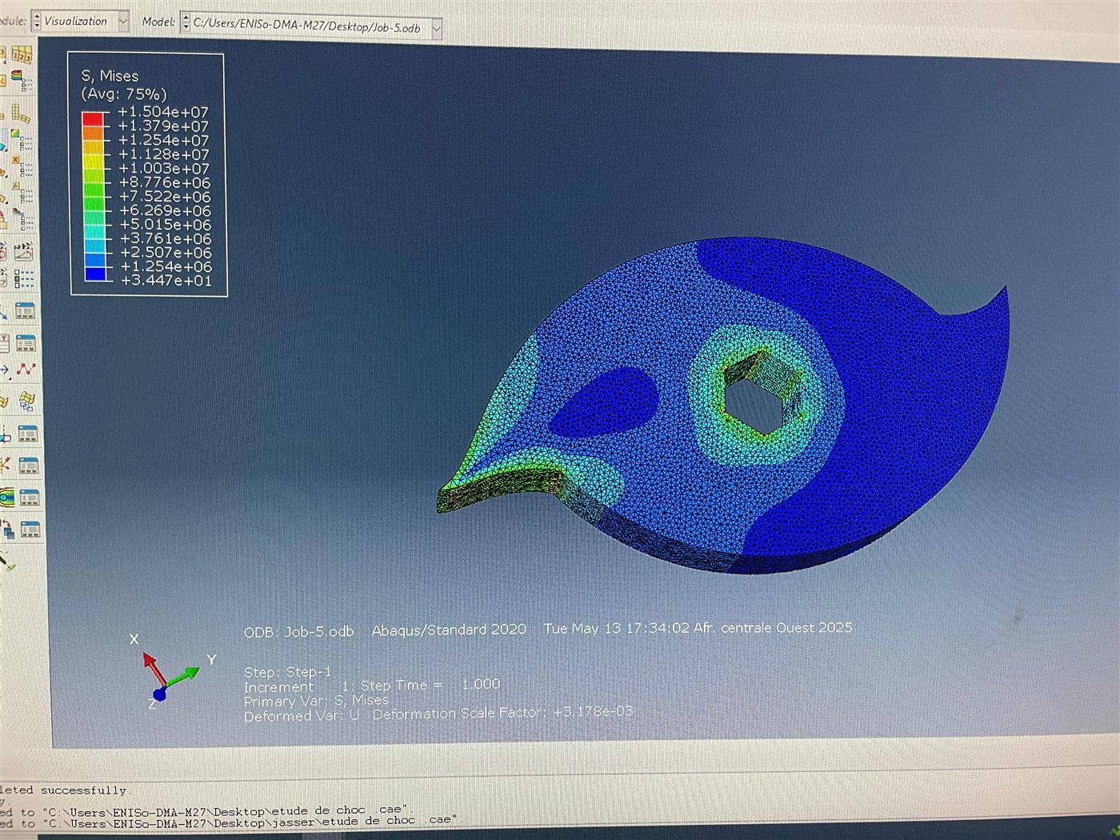
analysis/abaqus_impact/resultat_11.jpg
