jasser-bougatef/venom-combat-robot/analysis/abaqus_impact/resultat_13.jpg

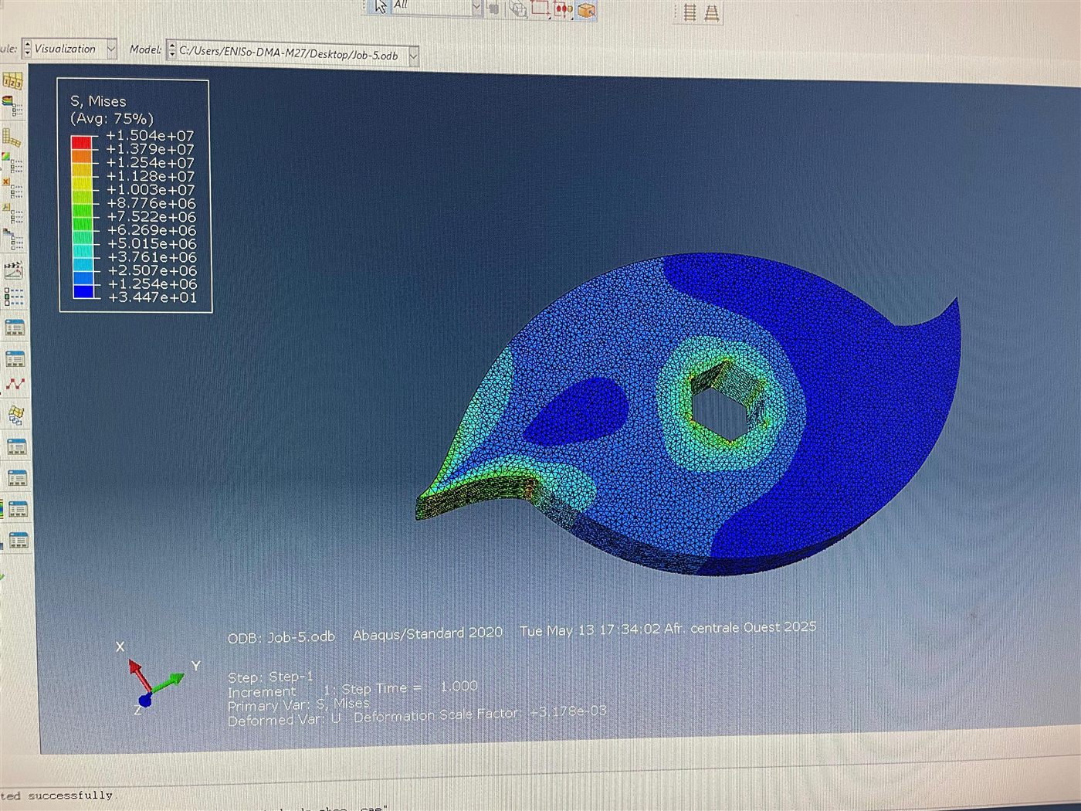
analysis/abaqus_impact/resultat_13.jpg
