jasser-bougatef/venom-combat-robot/analysis/abaqus_impact/resultat_14.jpg

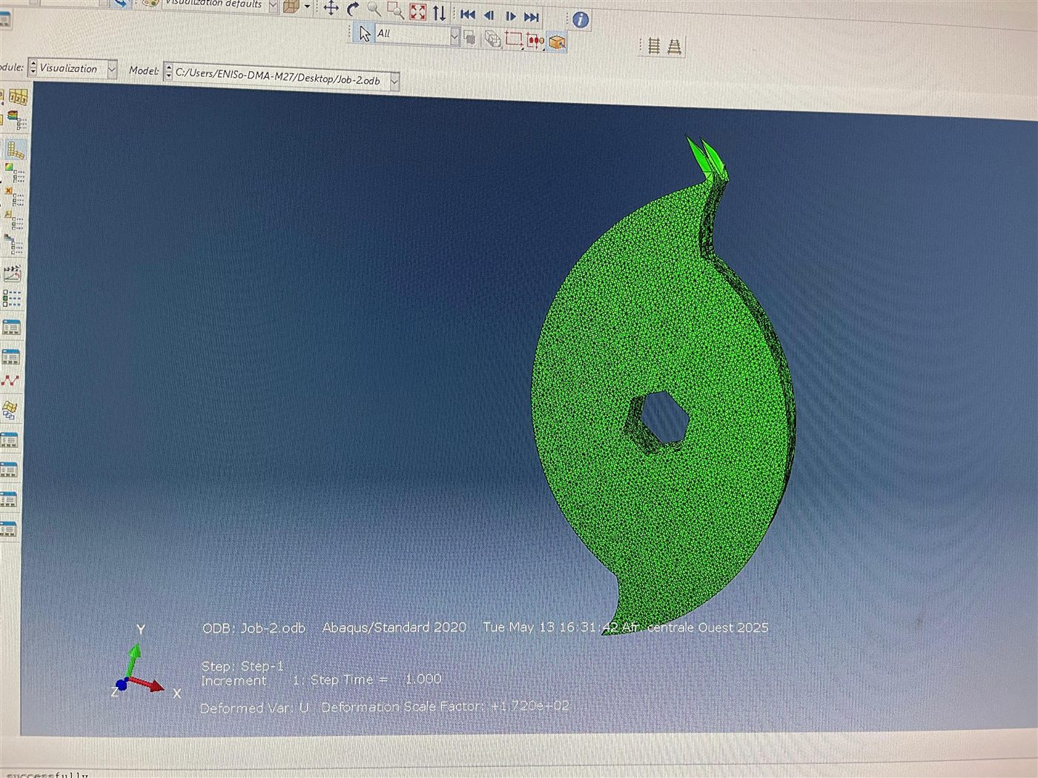
analysis/abaqus_impact/resultat_14.jpg
