jasser-bougatef/venom-combat-robot/(list of files, drawings)

Other design files:
electrical/proteus/venom.pdsprj
electrical/proteus/venom_v2.pdsprj
